applesnack23/smart-manufacture/PART03/부품그림/Adapter.png

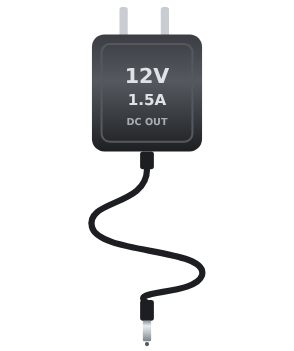
PART03/부품그림/Adapter.png
