applesnack23/smart-manufacture/PART03/부품그림/DCJack.png

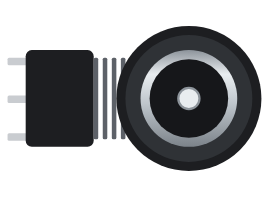
PART03/부품그림/DCJack.png
