applesnack23/smart-manufacture/PART03/부품그림/JGB37.png

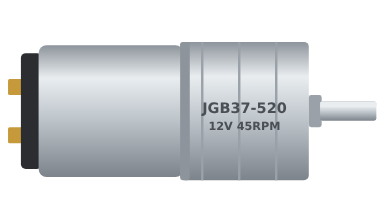
PART03/부품그림/JGB37.png
