applesnack23/smart-manufacture/PART03/부품그림/L298N.png

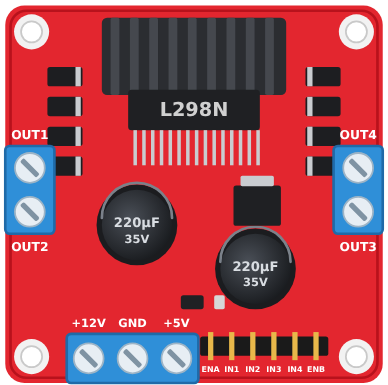
PART03/부품그림/L298N.png
