applesnack23/smart-manufacture/PART03/부품그림/L298N_pins.png

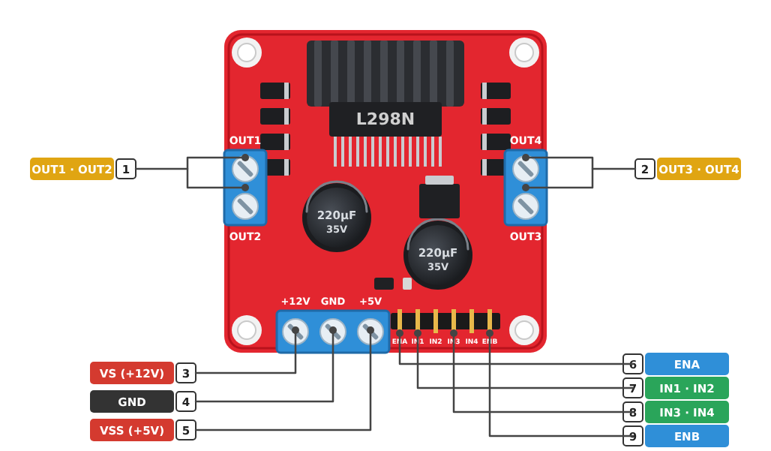
PART03/부품그림/L298N_pins.png
