applesnack23/smart-manufacture/PART03/부품그림/PiZero.png

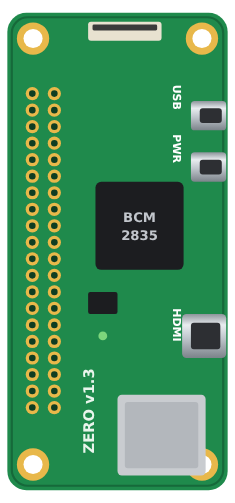
PART03/부품그림/PiZero.png
