applesnack23/smart-manufacture/PART03/부품그림/Switch.png

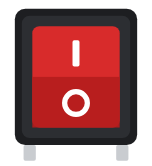
PART03/부품그림/Switch.png
