applesnack23/smart-manufacture/PART03/부품그림/TCRT5000.png

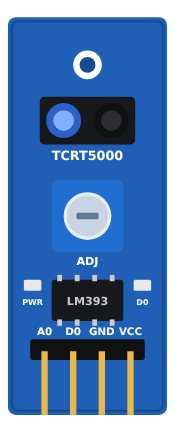
PART03/부품그림/TCRT5000.png
