applesnack23/smart-manufacture/PART02/부품목록.csv

구분 | 파일 | 부품 | 수량 | 재료 | 출력 방향 | 서포트 | 주요 치수 (mm)
3D 출력 | 02-01_측판_왼쪽.stl | 측판(왼쪽) | 1 | PLA | 넓은 면(바깥면)을 바닥에 | 장공 · 자리 위 필요 시 | 150 × 70 × 3, 베어링 자리 Ø12.2 깊이 3.6, 모터 축 장공
3D 출력 | 02-04_서포트너트.stl | 서포트 너트 | 5 | PLA | 세워서 (원형 단면) | 없음 | Ø6 × 50, 양끝 Ø2.2 × 10 구멍
3D 출력 | 02-06_받침판.stl | 받침판 | 1 | PLA | 넓은 면을 바닥에 | 없음 | 109.6 × 55.6 × 2.6, Ø10 구멍 36 개
3D 출력 | 02-10_아이들롤러.stl | 아이들 롤러 | 1 | PETG(또는 PLA) | 세워서, 층 0.12~0.16 | 없음 | 몸통 Ø14, 양끝 축 Ø7.9 (전체 55.8)
3D 출력 | 02-12_구동롤러.stl | 구동 롤러 | 1 | PETG(또는 PLA) | 세워서, 층 0.12~0.16 | 없음 | 몸통 Ø14, 긴 축 쪽 D 컷 (전체 76)
3D 출력 | 02-17_측판_오른쪽.stl | 측판(오른쪽) | 1 | PLA | 넓은 면(바깥면)을 바닥에 | 장공 · 자리 위 필요 시 | 150 × 70 × 3, 베어링 구멍 Ø12.2 관통 2 개
3D 출력 | 02-20_베어링커버.stl | 베어링 커버 | 2 | PLA | 윗면을 바닥에 (다리가 위로) | 없음 | 20 × 20, Ø3 구멍 4 개, TCRT5000 홀더
3D 출력 | 02-22_모터풀리_30T.stl | 모터 풀리 GT3 30T | 1 | PETG | 톱니가 세로가 되게, 층 0.12 | 없음 | D 구멍 Ø6.2
3D 출력 | 02-24_축풀리_20T.stl | 축 풀리 GT3 20T | 1 | PETG | 톱니가 세로가 되게, 층 0.12 | 없음 | D 구멍 Ø8.2, 고정 구멍 Ø3
3D 출력 | 02-29_공통패널.stl | 공통 패널 | 1 | PLA / PETG | 바닥판을 바닥에 | 끝판 구멍 · 창 | 138 × 44, DC 잭 Ø14, 퓨즈 홀더 Ø9, 스위치 창 15 × 10
3D 출력 | 02-31_라즈베리파이패널.stl | 라즈베리파이 패널 | 1 | PLA / PETG | 바닥판을 바닥에 | 끝판 구멍 · 창 | 스탠드오프 Ø5, 라즈베리파이 58 × 23 / L298N 36.5 × 36.5
3D 출력 | 02-35_케이블커버.stl | 케이블 커버 | 1 | PLA | 바닥에 눕혀서 | 없음 | 150 × 24 × 10 C 자 단면, 두께 2
3D 출력 | 02-15_벨트.stl | 컨베이어 벨트 | 1 | TPU | 고리를 눕혀서, 느린 속도 | 없음 | 안쪽 톱니 82 개, 자유 길이 약 301
구매 |  | JGB37-520 기어드 모터 (12 V, 45 rpm) | 1
구매 | STEP/MR128ZZ_bearing.step | MR128ZZ 베어링 | 4
구매 |  | GT3-159 타이밍 벨트 | 1
구매 |  | TCRT5000 센서 모듈 | 2
구매 |  | 나사 M2 × 6 / 8 / 10 (축 풀리 고정 M2 × 10 1 개 포함) | 필요한 만큼
구매 |  | 나사 M3 × 6 (모터 고정) | 필요한 만큼
