applesnack23/smart-manufacture/PART03/전기부품목록.csv

부품 | 수량 | 쓰는 곳 · 메모
12 V 1.5 A 어댑터 | 1 | 전원
DC 잭 DC-022B | 1 | 공통 패널, 12 V 입력
퓨즈 홀더 + 2 A 퓨즈 | 1 | 공통 패널
토글 스위치 | 1 | 공통 패널, 전원 ON/OFF
L298N 모터 드라이버 | 1 | 라즈베리파이 패널
라즈베리파이 제로 v1.3 | 1 | 라즈베리파이 패널, PC 와 USB 케이블 하나로 연결
TCRT5000 센서 모듈 | 2 | 센서 A · B
JGB37-520 기어드 모터 | 1 | 12 V
페룰 CE002506 | 필요한 만큼 | L298N 단자대 (N-3 두 가닥은 페룰 하나에)
110 REC 신주단자 | 2 | 모터 탭
듀폰 1P / 3P 하우징 · 핀 | 필요한 만큼 | 라즈베리파이 헤더 · 센서
번호 수축 튜브 | 전선마다 2 개 | 전선 양끝 번호 표시
전선 AWG24 (흰색 · 청색 · 빨간색 · 검정색) | 필요한 만큼 | 12 V 흰색, GND 청색, 3.3 V 빨간색, 신호 검정색
