applesnack23/smart-manufacture/PART02/STEP/JGB37-520.step

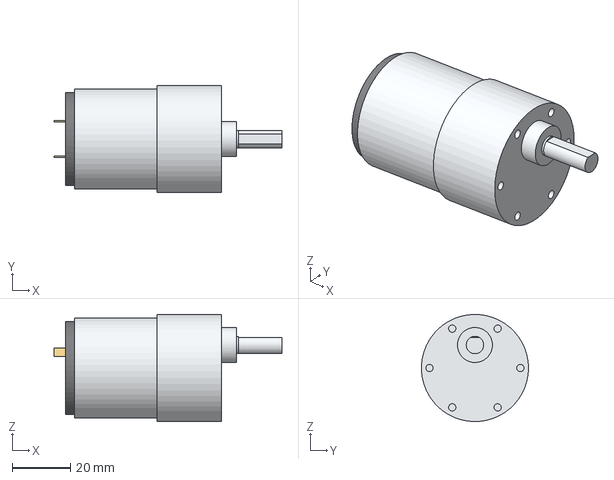
[picture p9: CAD file, 2026-11-13]
PART02/STEP/JGB37-520.step
78.3 x 36.8 x 36.8 mm
