applesnack23/smart-manufacture/PART02/STL/02-22_모터풀리_30T.stl

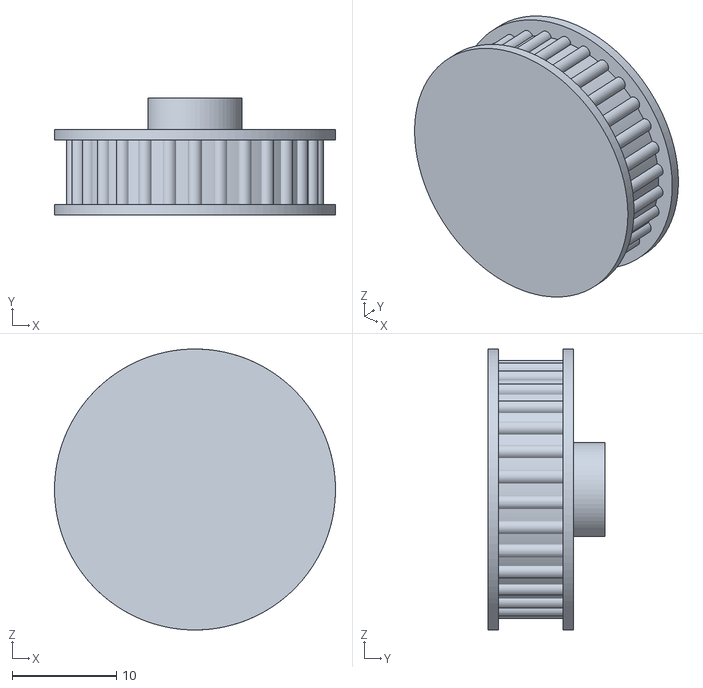
[picture p10: CAD file, 2026-11-13]
PART02/STL/02-22_모터풀리_30T.stl
27.0 x 11.2 x 27.0
