applesnack23/smart-manufacture/PART02/STEP/DC-022B.step

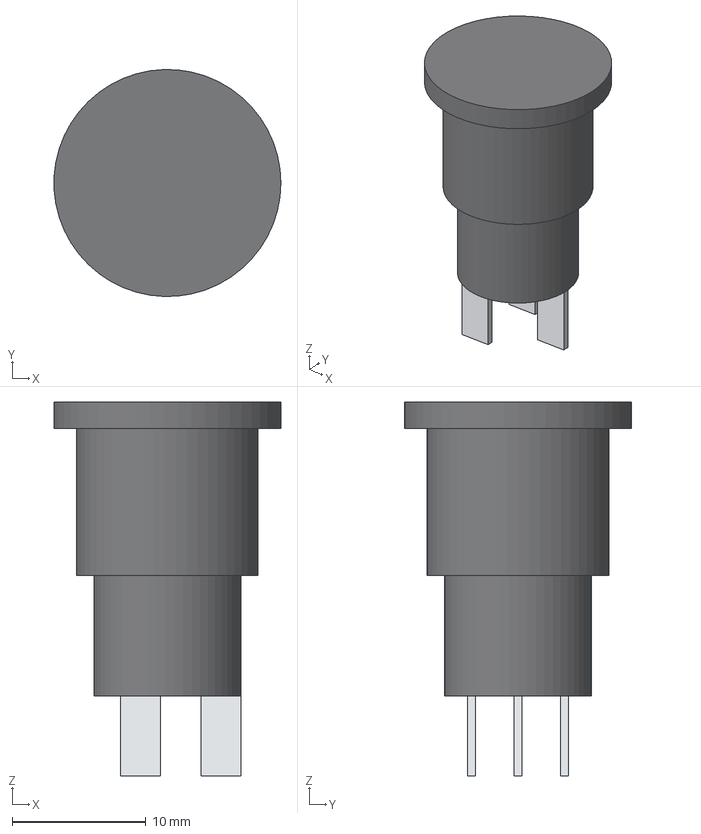
[picture p11: CAD file, 2026-11-13]
PART02/STEP/DC-022B.step
17.0 x 17.0 x 28.0 mm
