applesnack23/smart-manufacture/PART02/STL/02-04_서포트너트.stl

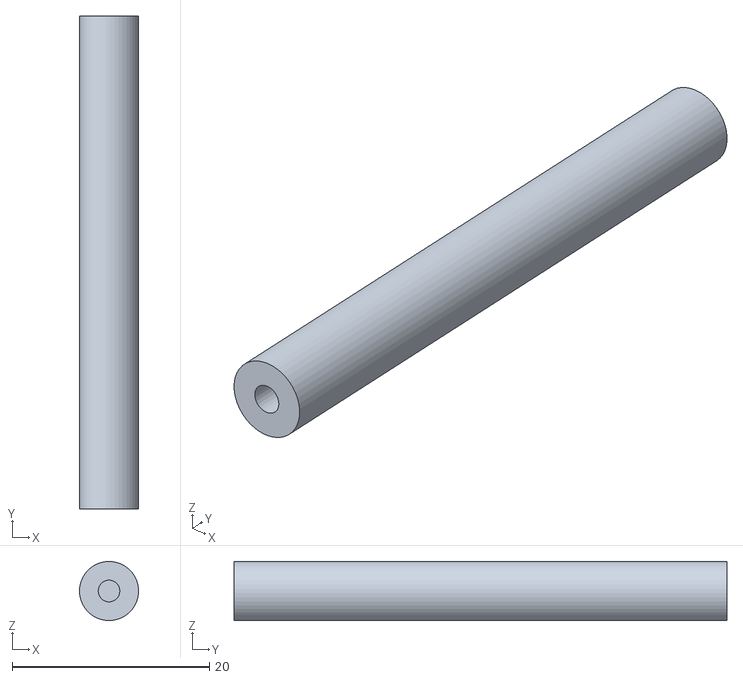
[picture p12: CAD file, 2026-11-13]
PART02/STL/02-04_서포트너트.stl
5.99 x 50.0 x 6.00
