applesnack23/smart-manufacture/PART02/STEP/L298N.step

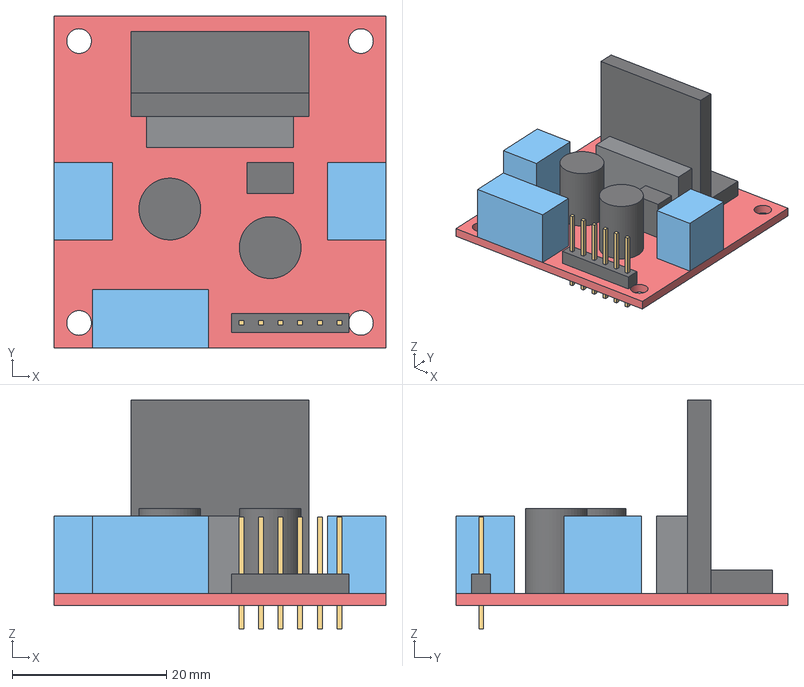
[picture p13: CAD file, 2026-11-13]
PART02/STEP/L298N.step
43.0 x 43.0 x 29.6 mm
