applesnack23/smart-manufacture/PART02/STL/02-06_받침판.stl

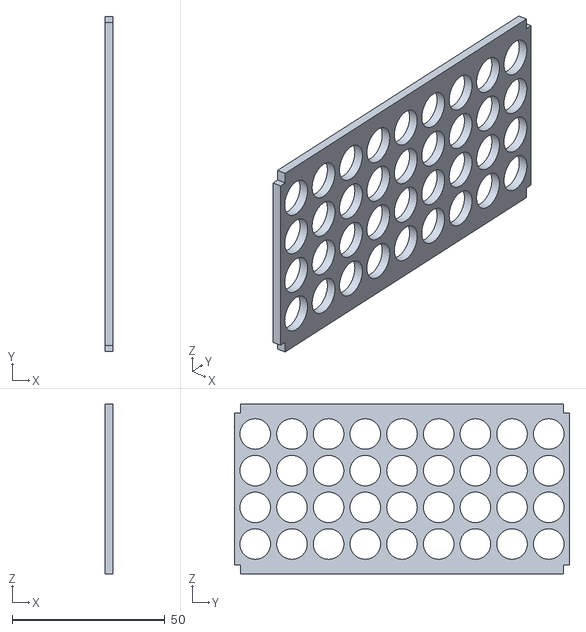
[picture p14: CAD file, 2026-11-13]
PART02/STL/02-06_받침판.stl
2.60 x 109.6 x 55.6
