applesnack23/smart-manufacture/PART02/STEP/Rocker_switch_KCD1.step

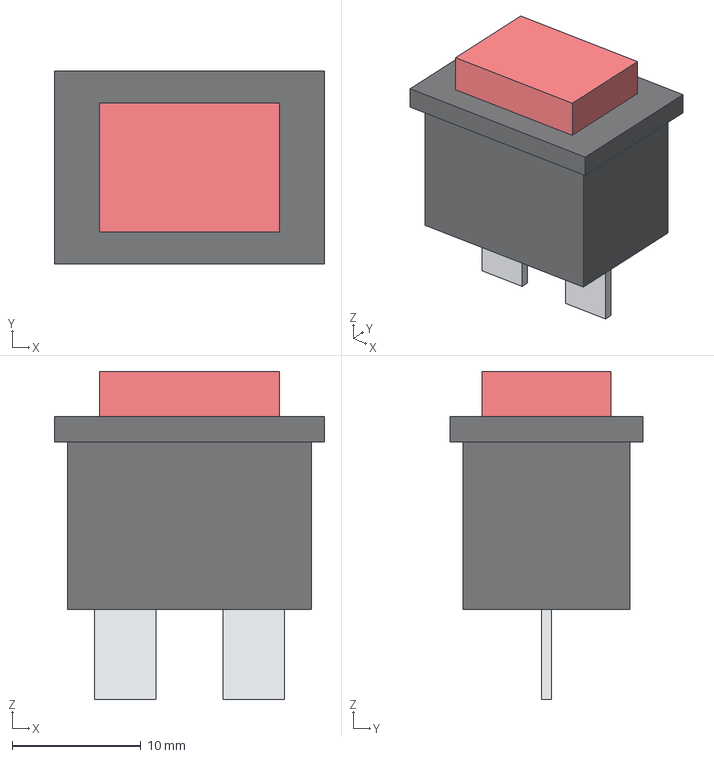
[picture p15: CAD file, 2026-11-13]
PART02/STEP/Rocker_switch_KCD1.step
21.0 x 15.0 x 25.5 mm
