applesnack23/smart-manufacture/PART02/STL/02-15_벨트.stl

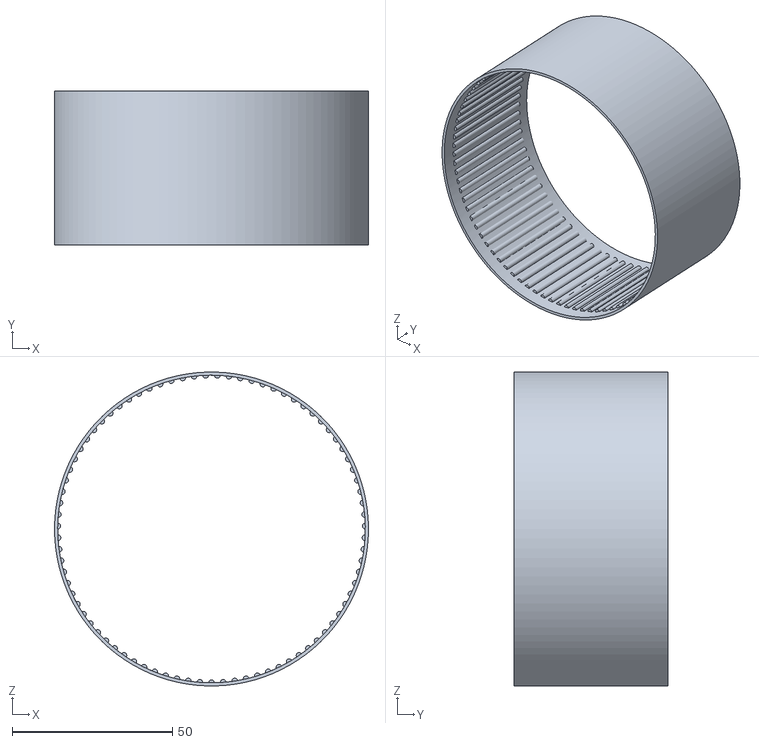
[picture p16: CAD file, 2026-11-13]
PART02/STL/02-15_벨트.stl
98.0 x 48.0 x 98.0
