applesnack23/smart-manufacture/PART02/STEP/Fuse_holder_5x20.step

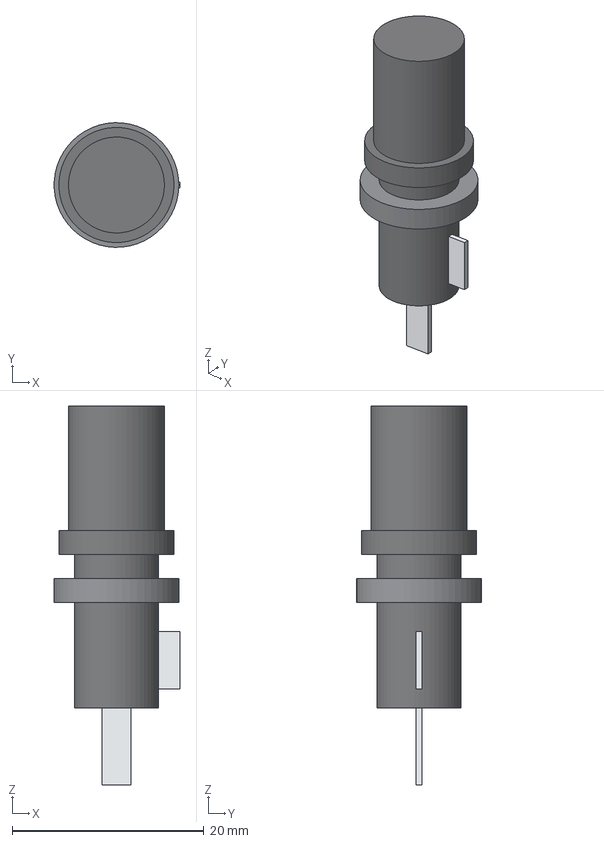
[picture p17: CAD file, 2026-11-13]
PART02/STEP/Fuse_holder_5x20.step
13.1 x 13.0 x 39.5 mm
