applesnack23/smart-manufacture/PART02/STL/02-31_라즈베리파이패널.stl

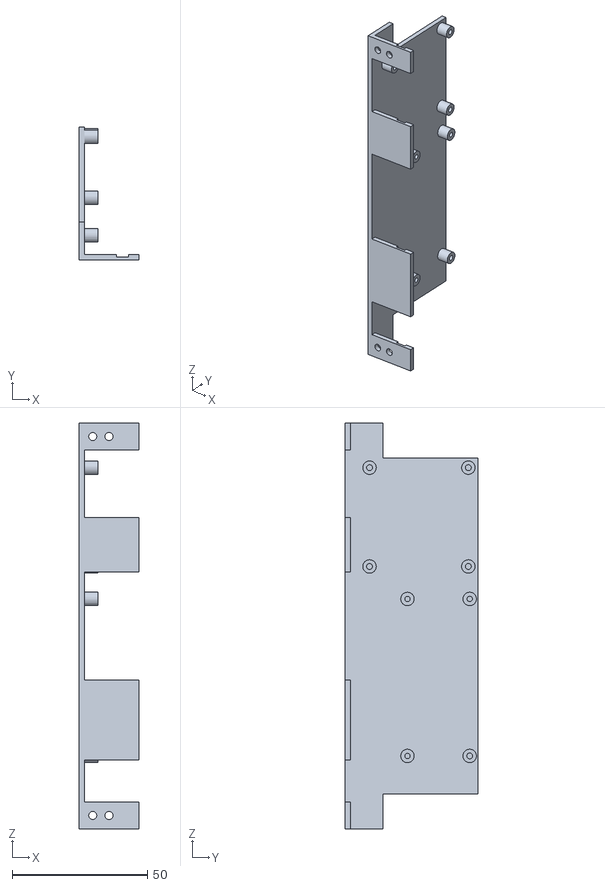
[picture p18: CAD file, 2026-11-13]
PART02/STL/02-31_라즈베리파이패널.stl
22.0 x 49.0 x 150.0
