applesnack23/smart-manufacture/PART02/STEP/MR128ZZ_bearing.step

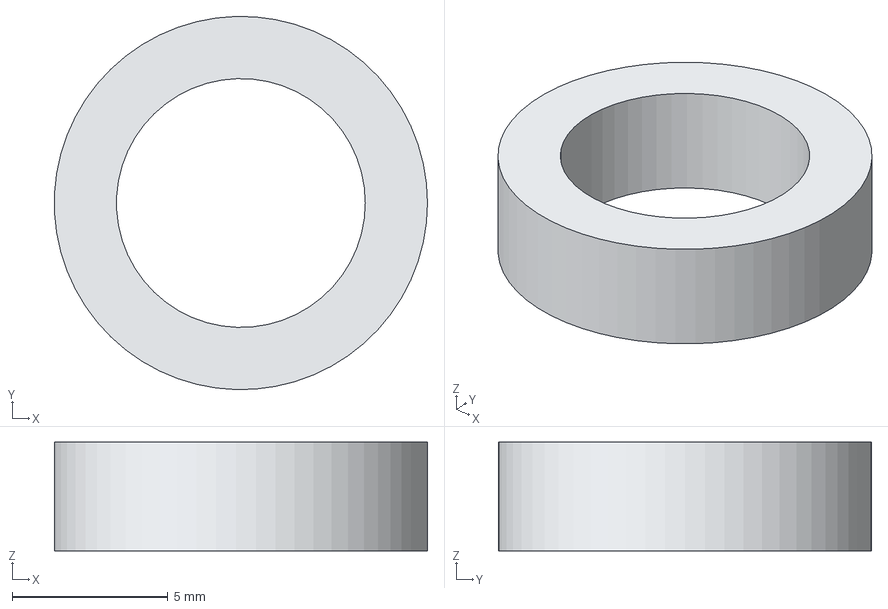
[picture p19: CAD file, 2026-11-13]
PART02/STEP/MR128ZZ_bearing.step
12.0 x 12.0 x 3.50 mm
