applesnack23/smart-manufacture/PART02/STL/02-01_측판_왼쪽.stl

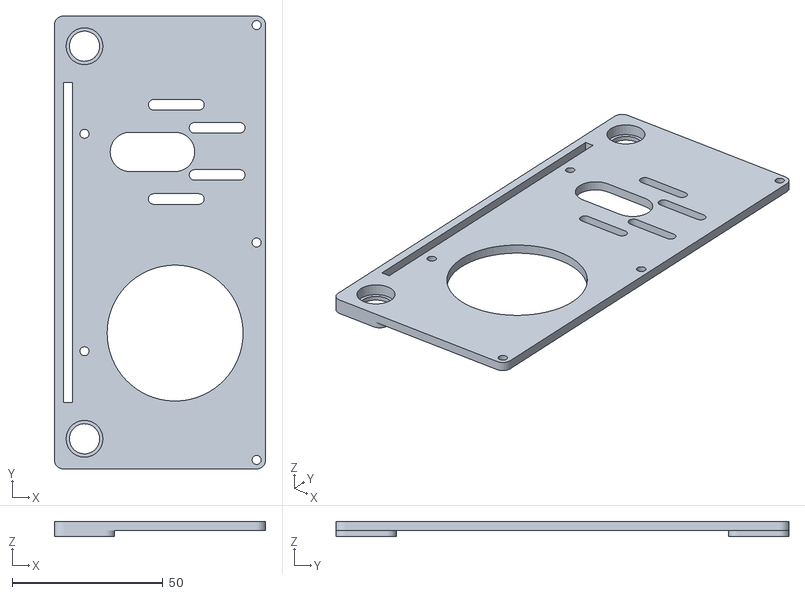
[picture p20: CAD file, 2026-11-13]
PART02/STL/02-01_측판_왼쪽.stl
70.0 x 150.0 x 5.00
