applesnack23/smart-manufacture/PART02/STEP/TCRT5000_module.step

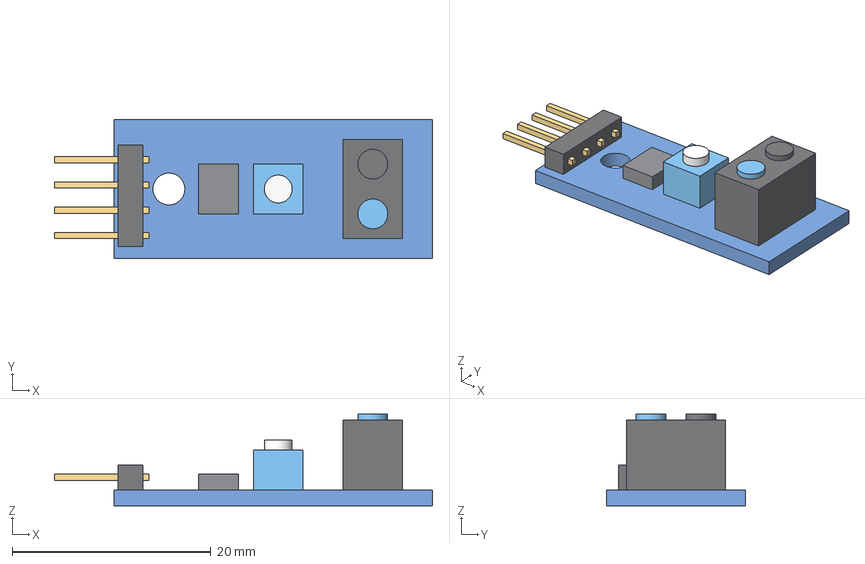
[picture p21: CAD file, 2026-11-13]
PART02/STEP/TCRT5000_module.step
38.0 x 14.0 x 9.20 mm
