applesnack23/smart-manufacture/PART02/STL/02-35_케이블커버.stl

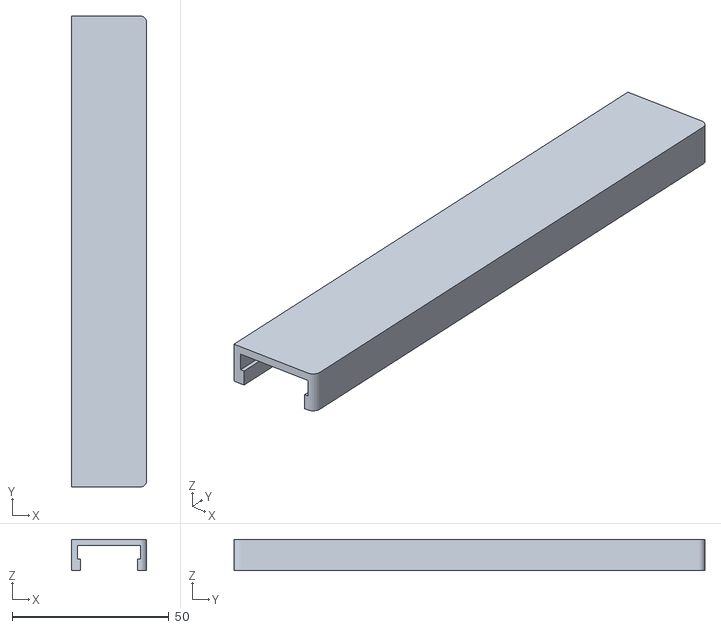
[picture p22: CAD file, 2026-11-13]
PART02/STL/02-35_케이블커버.stl
24.0 x 150.0 x 10.0
