applesnack23/smart-manufacture/PART02/STEP/RaspberryPi_Zero_v1.3.step

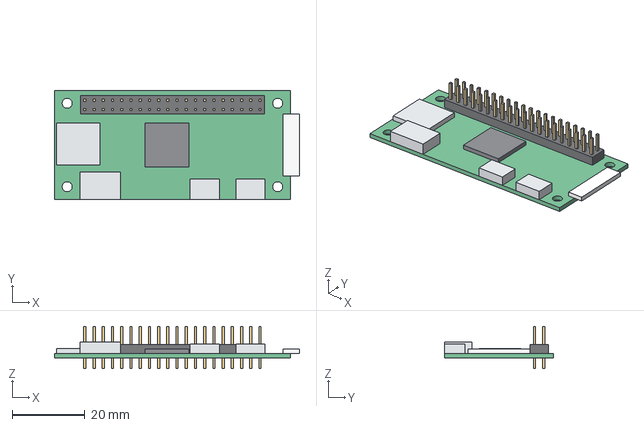
[picture p23: CAD file, 2026-11-13]
PART02/STEP/RaspberryPi_Zero_v1.3.step
67.5 x 30.0 x 11.7 mm
