applesnack23/smart-manufacture/PART02/STL/02-12_구동롤러.stl

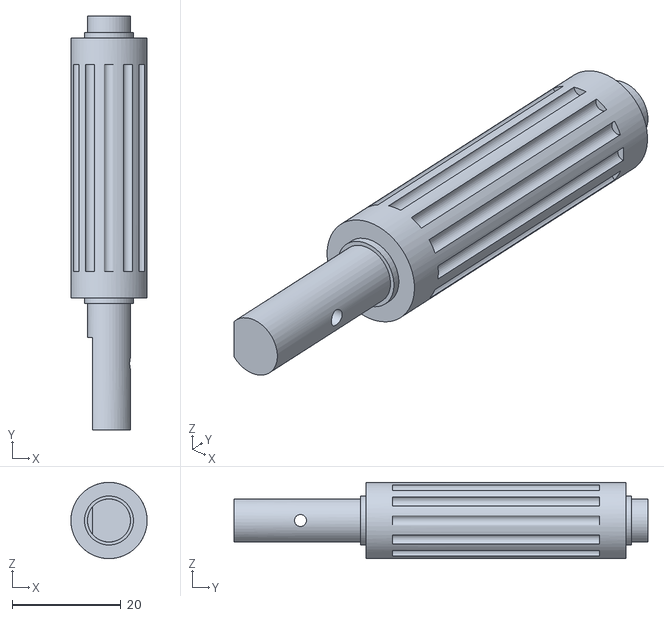
[picture p24: CAD file, 2026-11-13]
PART02/STL/02-12_구동롤러.stl
14.0 x 76.0 x 14.0
