applesnack23/smart-manufacture/PART02/STL/02-24_축풀리_20T.stl

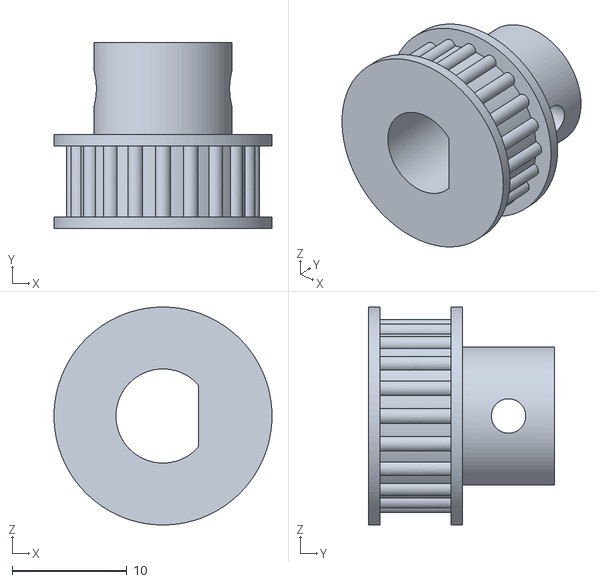
[picture p25: CAD file, 2026-11-13]
PART02/STL/02-24_축풀리_20T.stl
19.0 x 16.2 x 19.0
