applesnack23/smart-manufacture/PART02/STL/02-10_아이들롤러.stl

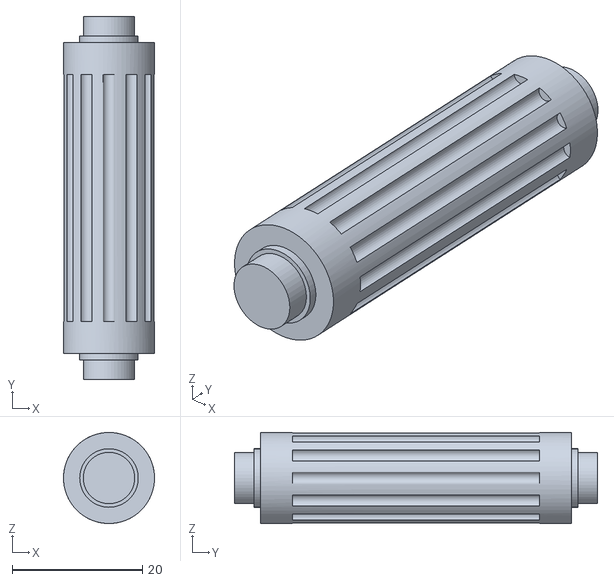
[picture p26: CAD file, 2026-11-13]
PART02/STL/02-10_아이들롤러.stl
14.0 x 55.8 x 14.0
