applesnack23/smart-manufacture/PART02/STL/02-29_공통패널.stl

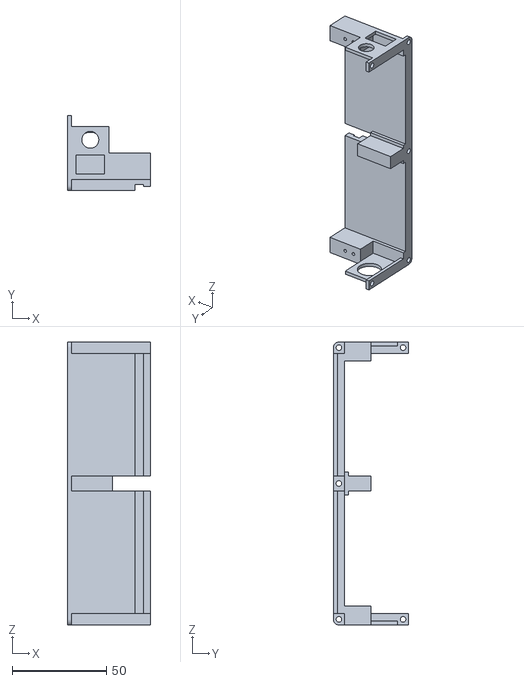
[picture p27: CAD file, 2026-11-13]
PART02/STL/02-29_공통패널.stl
44.0 x 40.0 x 150.0
