applesnack23/smart-manufacture/PART02/STL/02-17_측판_오른쪽.stl

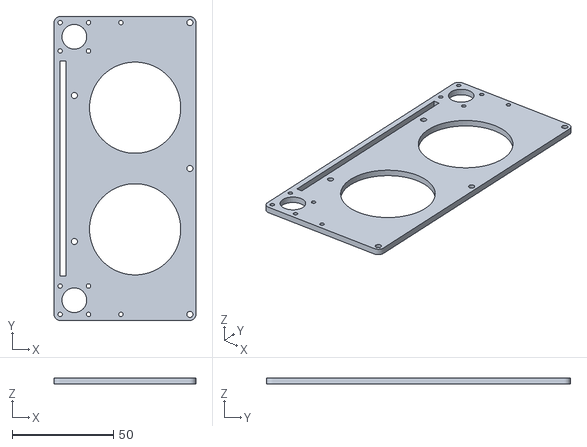
[picture p28: CAD file, 2026-11-13]
PART02/STL/02-17_측판_오른쪽.stl
70.0 x 150.0 x 3.00
