applesnack23/smart-manufacture/PART02/STL/02-20_베어링커버.stl

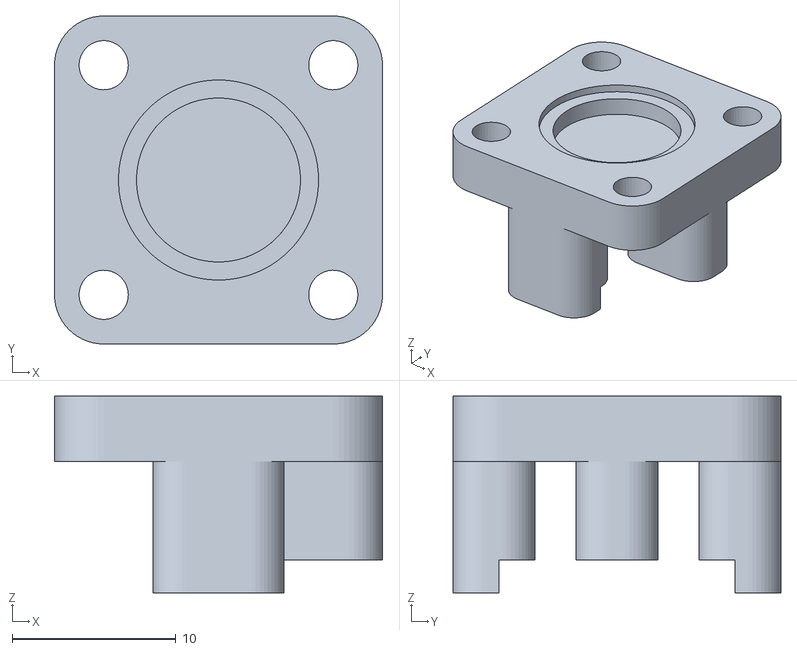
[picture p29: CAD file, 2026-11-13]
PART02/STL/02-20_베어링커버.stl
20.0 x 20.0 x 12.0
