applesnack23/smart-manufacture/(list of files, cad)

Other CAD files:
PART02/F3D/02-00_컨베이어_조립품.f3z
PART02/F3D/02-01_측판_왼쪽.f3d
PART02/F3D/02-04_서포트너트.f3d
PART02/F3D/02-06_받침판.f3d
PART02/F3D/02-10_아이들롤러.f3d
PART02/F3D/02-12_구동롤러.f3d
PART02/F3D/02-15_벨트.f3d
PART02/F3D/02-17_측판_오른쪽.f3d
PART02/F3D/02-20_베어링커버.f3d
PART02/F3D/02-22_모터풀리_30T.f3d
PART02/F3D/02-24_축풀리_20T.f3d
PART02/F3D/02-27_풀리벨트.f3d
PART02/F3D/02-29_공통패널.f3d
PART02/F3D/02-31_라즈베리파이패널.f3d
PART02/F3D/02-35_케이블커버.f3d
PART02/F3D/공통패널.f3d
PART02/F3D/구동롤러.f3d
PART02/F3D/라즈베리파이판넬.f3d
PART02/F3D/받침판.f3d
PART02/F3D/베어링커버.f3d
PART02/F3D/벨트.f3d
PART02/F3D/서포트너트.f3d
PART02/F3D/아이들롤러.f3d
PART02/F3D/축풀리.f3d
PART02/F3D/측판(오른쪽).f3d
PART02/F3D/측판(왼쪽).f3d
PART02/F3D/컨베이어_조립품.f3z
PART02/F3D/케이블커버.f3d
PART02/F3D/풀리_모터.f3d
PART02/F3D/풀리벨트.f3d
