applesnack23/smart-manufacture/PART02/STEP/README.md

# 구매 부품 STEP (단순화 모델)

조립 모델에서 구매 부품의 자리 · 크기를 확인하기 위한 **직접 만든 단순화 모델**입니다.
상자와 원기둥으로만 만들었고, 치수는 일반적인 판매 부품의 대표 치수입니다. 실제 부품과 조금 다를 수 있으니 구멍 위치 · 단자 위치는 실물로 확인합니다.

| 파일 | 부품 | 원점 · 방향 |
|---|---|---|
| `L298N.step` | L298N 모터 드라이버 (43 × 43) | 기판 왼쪽 아래 모서리 아랫면 |
| `TCRT5000_module.step` | TCRT5000 센서 모듈 (32 × 14) | 기판 왼쪽 아래 모서리, 핀은 −X 쪽 |
| `Rocker_switch_KCD1.step` | 전원 스위치 (21 × 15) | 패널 앞면 중심 (z = 0), 몸통은 −Z |
| `DC-022B.step` | DC 잭 | 패널 앞면 중심 (z = 0) |
| `Fuse_holder_5x20.step` | 퓨즈 홀더 (5 × 20 퓨즈) | 패널 앞면 중심 (z = 0) |
| `RaspberryPi_Zero_v1.3.step` | 라즈베리파이 제로 v1.3 (65 × 30) | 기판 왼쪽 아래 모서리 아랫면 |
| `JGB37-520.step` | JGB37-520 기어드 모터 | 기어박스 앞면 중심, 출력축은 +X |
| `MR128ZZ_bearing.step` | MR128ZZ 베어링 (안 8 · 바깥 12 · 폭 3.5) | 한쪽 면 중심, 축 +Z |

Fusion 에서 **삽입 → 데이터 업로드** 또는 **파일 → 열기** 로 불러온 뒤 조립 모델에 배치합니다.

## 장착 구멍

| 부품 | 구멍 | 위치 (원점 기준, mm) |
|---|---|---|
| L298N | Ø3.2 관통 × 4 (M3) | (3.25, 3.25) · (39.75, 3.25) · (3.25, 39.75) · (39.75, 39.75) — 간격 36.5 × 36.5 |
| 라즈베리파이 제로 | Ø2.75 관통 × 4 (M2.5) | (3.5, 3.5) · (61.5, 3.5) · (3.5, 26.5) · (61.5, 26.5) — 간격 58 × 23 |
| TCRT5000 모듈 | Ø3.2 관통 × 1 (M3) | (5.5, 7) — 핀 바로 옆 (실물로 확인) |
| JGB37-520 | M3 탭 구멍 × 6 (Ø2.5, 깊이 6) | 기어박스 앞면, PCD 31.2, 60° 간격 (0° · 60° · … · 300°, 축은 90° 방향으로 7.9 편심) |

모터 치수: 기어박스 Ø36.8 × 22.2, 모터 Ø34.5 × 28.4, 출력축 Ø6 × 20.7 — 끝에서 15 mm 가 D 컷 (평면이 중심에서 2.5, 두께 5.5. 모터 풀리 D 구멍과 같은 값), 보스 Ø12 × 5.
