applesnack23/smart-manufacture/PART02/STEP/미리보기.png

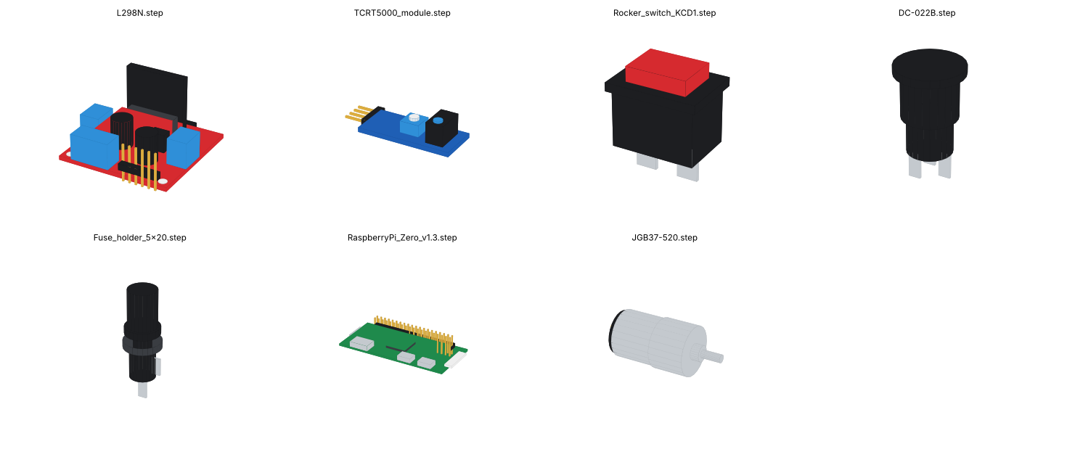
PART02/STEP/미리보기.png
