applesnack23/smart-manufacture/PART03/ConveyorRaspberryPi.pdf

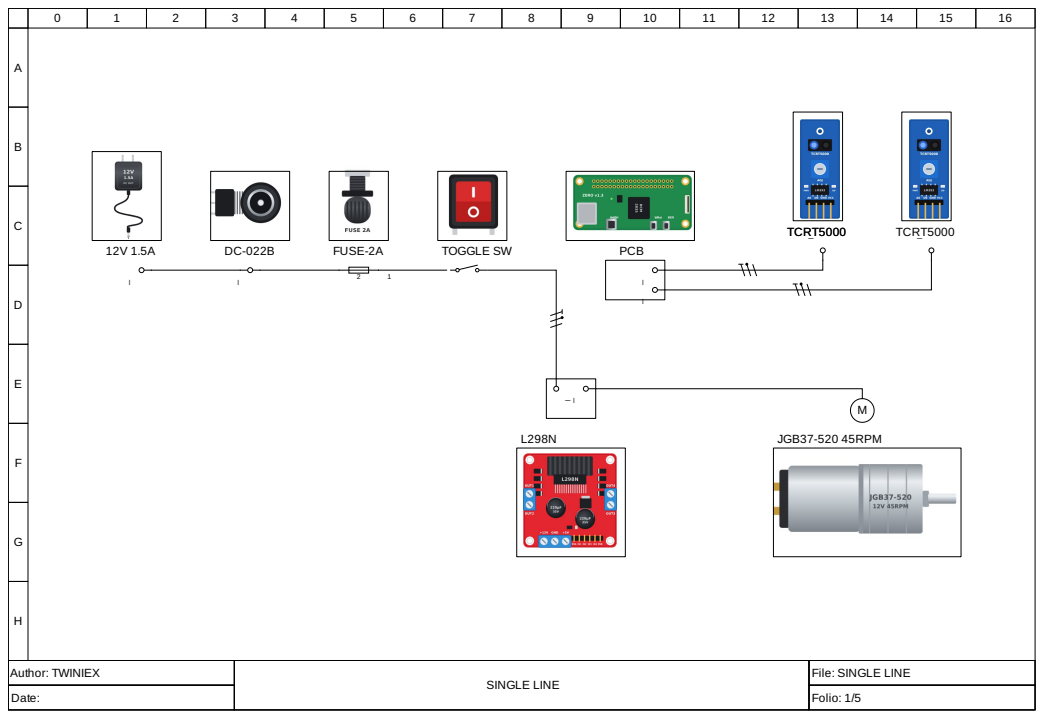
[picture p31: page 1]
PCB; JGB37-520 45RPM; FUSE-2A; TCRT5000; TOGGLE SW

Author: TWINIEX | SINGLE LINE | File: SINGLE LINE
Date: | | Folio: 1/5

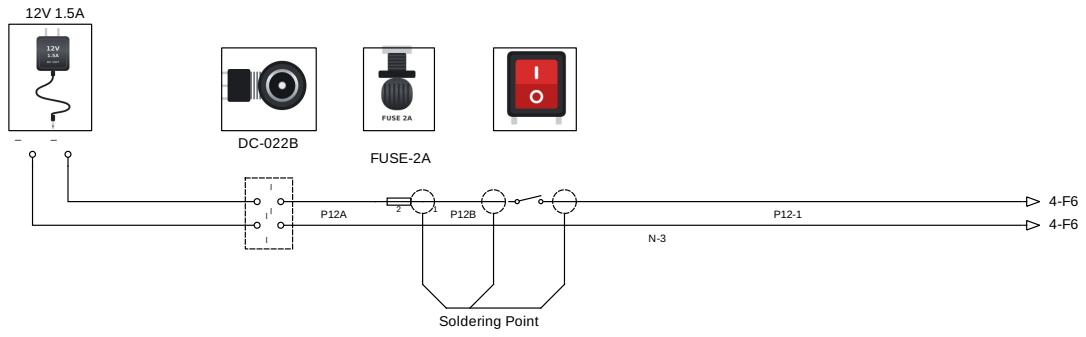
[picture p32: page 2]
Author: TWINIEX; POWER MAIN; FUSE-2A; Soldering Point; JST

File: POWER MAIN

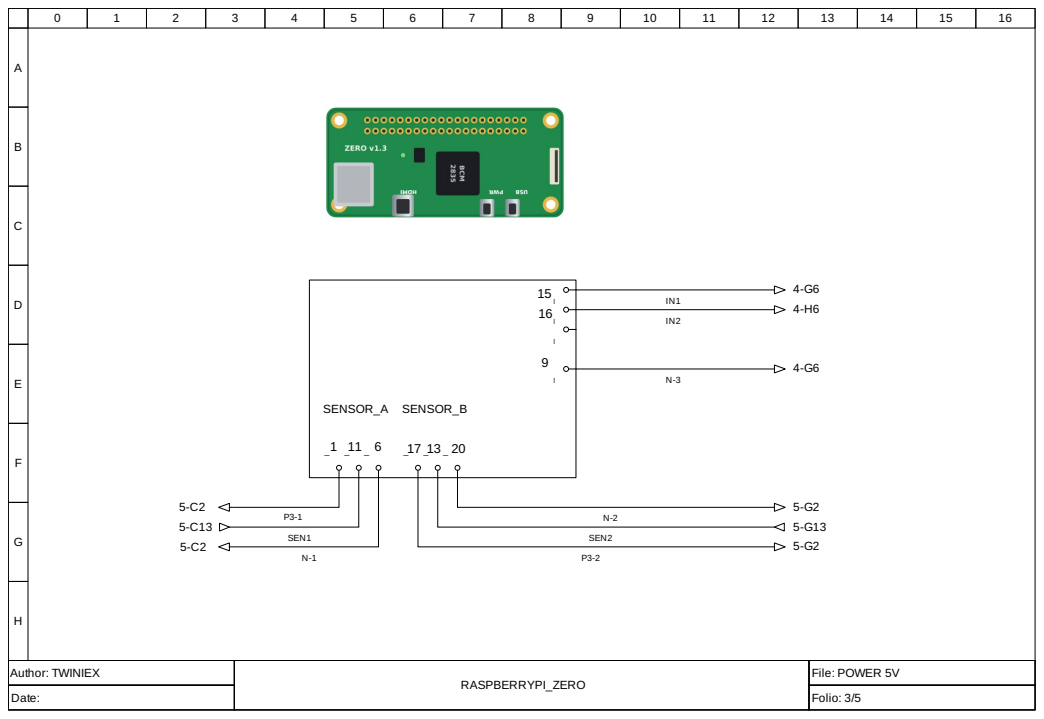
[picture p33: page 3]
Author: TWINIEX; RASPBERRYPI_ZERO; File: POWER 5V; SENSOR_A SENSOR_B; SEN1; SEN2

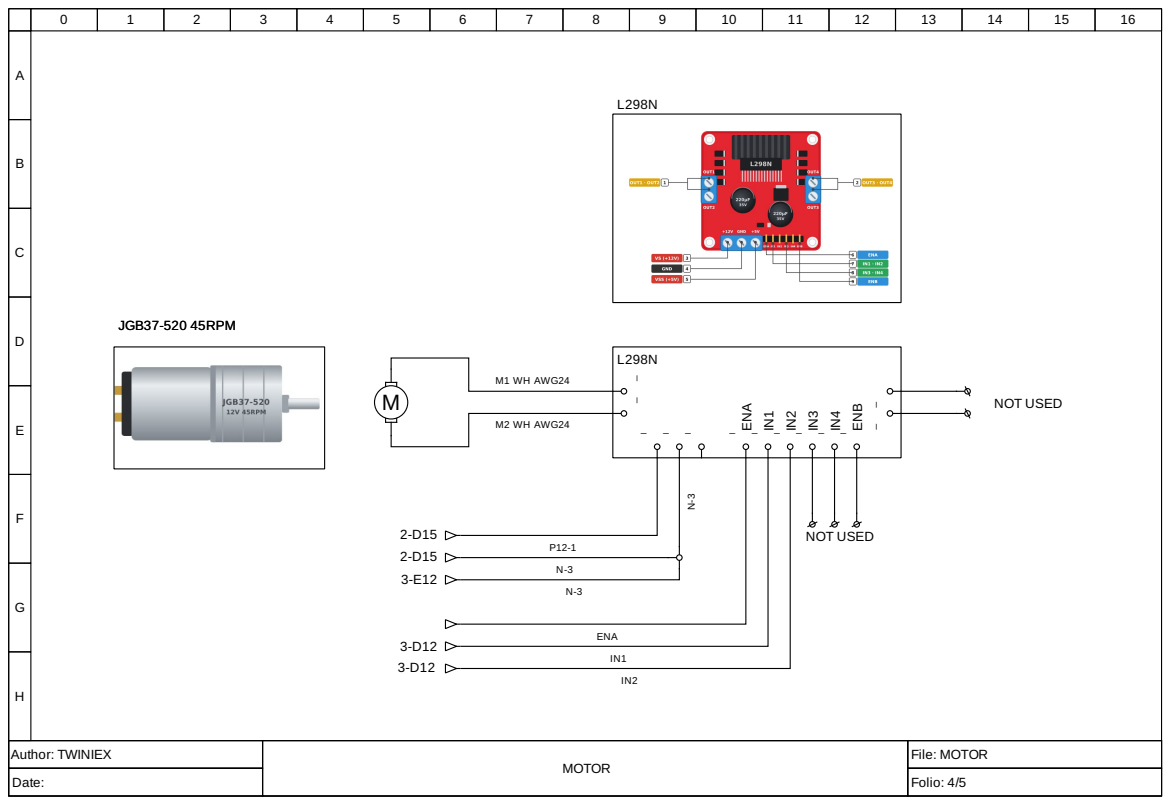
[picture p34: page 4]
Author: TWINIEX; MOTOR; File: MOTOR; JGB37-520 45RPM; NOT USED; ENA; M2 WH AWG24; M1 WH AWG24

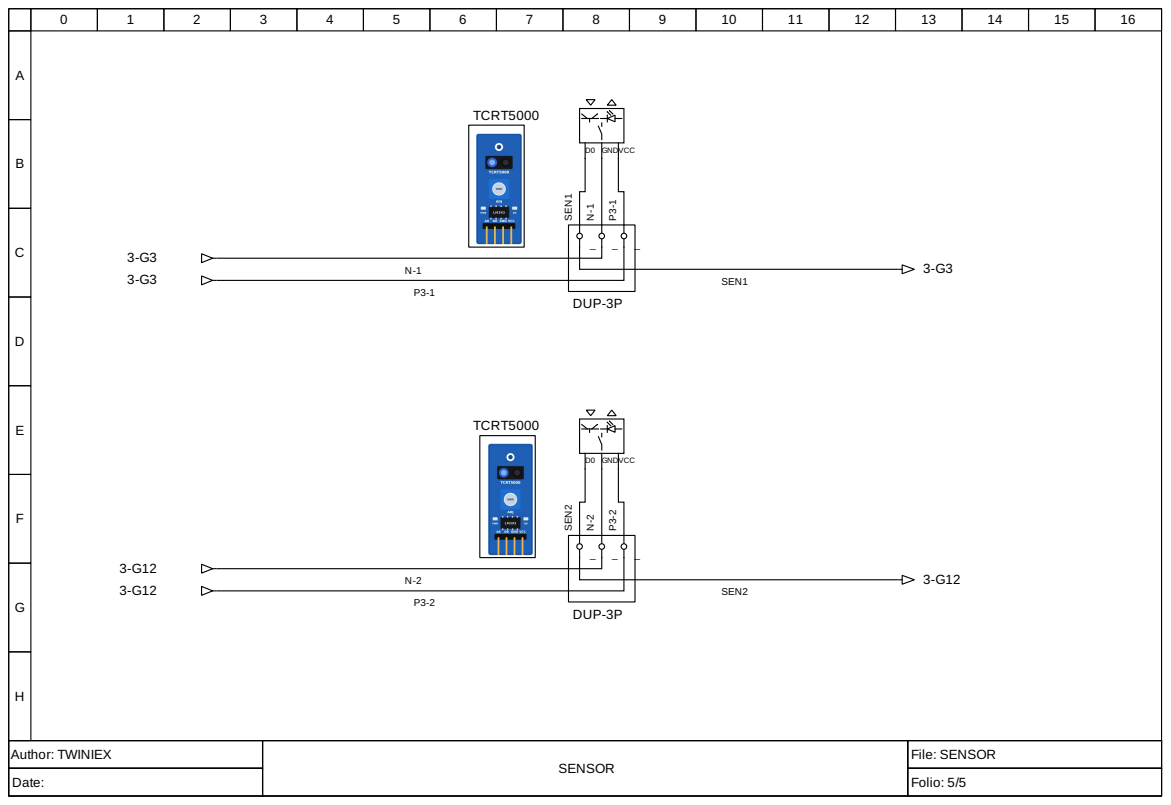
[picture p35: page 5]
Author: TWINIEX; SENSOR; File: SENSOR; GNDVCC; DUP-3P; TCRT5000; SEN2; SEN1; SEN1 SEN2
