applesnack23/smart-manufacture/PART06/ld1_sensor.st

PROGRAM conveyor
  VAR
    RAW_A    AT %IX0.3 : BOOL;     (* 센서 A 원래 값  GPIO17 · 물리 11번 *)
    RAW_B    AT %IX0.4 : BOOL;     (* 센서 B 원래 값  GPIO27 · 물리 13번 *)
    SENSOR_A AT %QX1.3 : BOOL;     (* 센서 A  1 = 감지 (렁 0 에서 뒤집음) *)
    SENSOR_B AT %QX1.4 : BOOL;     (* 센서 B  1 = 감지 *)
    MOVE_RIGHT AT %QX0.2 : BOOL;  (* 정방향  GPIO23 · 물리 16번 = IN1 *)
    MOVE_LEFT  AT %QX0.3 : BOOL;  (* 역방향  GPIO24 · 물리 18번 = IN2 *)
  END_VAR
  (* 0 : 센서 뒤집기 — D0 는 감지 = 0 이므로 NOT 으로 1 = 감지 *)
  SENSOR_A := NOT RAW_A;
  SENSOR_B := NOT RAW_B;
  (* 1 : 센서 A 가 박스를 보는 동안만 정방향 *)
  MOVE_RIGHT := SENSOR_A;
END_PROGRAM

CONFIGURATION Config0
  RESOURCE Res0 ON PLC
    TASK task0(INTERVAL := T#50ms, PRIORITY := 0);
    PROGRAM instance0 WITH task0 : conveyor;
  END_RESOURCE
END_CONFIGURATION
