applesnack23/smart-manufacture/(commit log)

2026-11-12 교재 예제 · 데이터 · 완성 소스
    [il_dataset.csv, sl_dataset.csv]
2026-11-13 raspberry pi image
